Boisti13/esp32-sendspin-speaker/README.md

# ESP32 Sendspin Speaker






A network speaker for Home Assistant and Music Assistant on an ESP32-A1S
audio board. It plays [Sendspin](https://www.sendspin-audio.com/) streams
(Music Assistant's synchronised multi-room audio), shows what's playing on a
small colour screen and has hardware buttons for play/pause, volume and
tracks. Built with ESPHome.

> Since v0.2.0 it uses the Sendspin components built into ESPHome 2026.10;
> no pull requests or external components any more.

## Highlights

- **Sendspin player**: shows up in Music Assistant as a player and plays in
  sync with other Sendspin speakers.
- **ES8388 codec** on the A1S board, stereo, 48 kHz / 32-bit I²S; output
  set to both outputs (speaker and headphone) at boot, on the device itself.
- **Amplifier switched with playback**: on 150 ms after playback starts
  (no pop while the codec settles), off 300 ms after it stops or pauses (no
  click on the last audio).
- **1.47" screen** (320 × 172 landscape, ST7789V): play/pause icon, volume,
  IP address, title and artist. Long names end in "...", accented letters
  (ä, ö, ü, ß, é) are in the font. Redrawn only when something changes.
- **Rides out Wi-Fi gaps**: 2.5 MB of audio buffered ahead in PSRAM
  (Sendspin's default is 1 MB, about 5 s).
- **Diagnostics in Home Assistant**: Wi-Fi signal, uptime, free PSRAM and
  heap, and the reason for the last restart. A signal worse than about −70 dBm means dropouts: move the speaker
  or the access point, or use a board with an external antenna.
- **Five buttons that work without Home Assistant**: play/pause, previous,
  next, volume down/up go straight to the player and on to Music Assistant
  through Sendspin. Headphone jack detection.
- **Play picks up where you left off**: with nothing playing, even right
  after power-on, button 1 asks Music Assistant to play, and it resumes
  the speaker's queue with the last track.
- **Chime when it's online**: a short three-note chime when Wi-Fi first
  connects after power-on (not on later reconnects, and not over music).
  Built into the firmware. *Boot Sound* in Home Assistant turns it off;
  the setting survives restarts.

## Hardware

| Part | |
|---|---|
| Board | ESP32-A1S audio kit (ESP32-WROVER with PSRAM, ES8388 codec) |
| Codec | ES8388, I²C SDA 33 / SCL 32; I²S LRCLK 25, BCLK 27, DOUT 26, MCLK 0 |
| Amplifier enable | GPIO21 |
| Screen | Waveshare 1.47" 172 × 320, ST7789V; SPI CLK 14, MOSI 13, CS 15, DC 22, RST 12 |
| Headphone jack detect | GPIO39 |

### Buttons

| Button | Pin | Does | Entity in Home Assistant |
|---|---|---|---|
| 1 | GPIO36 | pause; when not playing, play (resumes Music Assistant's queue) | *Button 1 Play/Pause* |
| 2 | — | its pin (GPIO13) is the screen's MOSI | — |
| 3 | GPIO19 | previous track | *Button 3 Previous Track* |
| 4 | GPIO23 | next track | *Button 4 Next Track* |
| 5 | GPIO18 | volume down | *Button 5 Volume Down* |
| 6 | GPIO5 | volume up | *Button 6 Volume Up* |

The numbers are the ones printed on the board (KEY1–KEY6).

GPIO12 (screen reset) is a strapping pin: if it is high at power-on the
ESP32 picks 1.8 V flash and doesn't boot. Worth moving if boot is flaky.

### Custom PCB (in design)

A battery-powered board set of its own is being designed in KiCad in
[`hardware/`](hardware/README.md): a main board with the same ESP32-A1S
module, two 3 W amplifiers, a 1S LiPo charger and one USB-C port for
charging and flashing; a front panel with the screen (SPI like this one,
or an I²C OLED) and the buttons; a small USB-C board. Panel, USB-C,
battery, speakers, status LED, on/off switch and charge LEDs connect by
JST cable. It keeps the pins above, screen included, so it will get its
own `speaker-diy.yaml` with few changes. Not built yet.

## Install

| Step | |
|---|---|
| 1 | Copy `secrets.example.yaml` to `secrets.yaml` and fill in Wi-Fi, a new API key (`openssl rand -base64 32`) and an OTA password. In Home Assistant's ESPHome app the shared `secrets.yaml` gets `speaker_1_key` and `speaker_1_ota_password`. |
| 2 | Put `speaker.yaml`, `fonts/` and `sounds/` into the ESPHome folder. |
| 3 | Flash once over USB: `esphome run speaker.yaml`. After that, over Wi-Fi. |
| 4 | Add the device in Home Assistant with the API key. It needs no Home Assistant actions. |
| 5 | In Music Assistant, enable the Sendspin provider; the speaker appears as a player. |

## Example: playing an album

Start an album in Music Assistant on *Sendspin Media Player*. The board
switches to *playing*, waits 150 ms, turns the amplifier on and two seconds
later draws the screen once: pause icon, `VOL 65%`, the title in large type
and the artist below (*Die Ärzte* shows with its umlaut; a long title ends
in "..."). Press button 6 and the volume goes up a step; the screen redraws
with the new value. Press button 4 and Music Assistant skips to the next track.
Press button 1 to pause: the icon changes to play and the amplifier turns off
300 ms later.

## Layout

```
speaker.yaml           the whole device: board, codec, Sendspin, screen, buttons
requirements.txt       the ESPHome version it is tested with
fonts/                 Ubuntu Medium and Material Design Icons for the screen
sounds/boot.wav        the boot chime (1.5 s, 22 kHz mono)
scripts/make-boot-sound.py  makes sounds/boot.wav (synthesised, MIT like the rest)
secrets.example.yaml   the secrets the config expects
hardware/              KiCad 10 projects for the custom PCBs: main, front panel, USB-C (CERN-OHL-P-2.0)
```

## Development

- Check a change: `esphome config speaker.yaml`, then
  `esphome compile speaker.yaml`.
- ESPHome **2026.10.0** (`requirements.txt`), the version of Home
  Assistant's ESPHome app. Sendspin, `speaker_source` and `media_source`
  are built in since then; older versions don't have them.
- The screen has `update_interval: never`: every change that shows on it
  calls `component.update: tft_display`.
- Another boot sound: replace `sounds/boot.wav` (WAV, MP3, FLAC or Opus,
  short, ideally with ~300 ms of silence in front so the amplifier is on
  when it starts) or change and run `scripts/make-boot-sound.py`.

## License

MIT, see [LICENSE](LICENSE). The hardware in `hardware/` is under
CERN-OHL-P-2.0, see [hardware/LICENSE](hardware/LICENSE). Fonts: see
[THIRD_PARTY_NOTICES.md](THIRD_PARTY_NOTICES.md).
