Boisti13/esp32-sendspin-speaker/hardware/docs/main-bottom.png

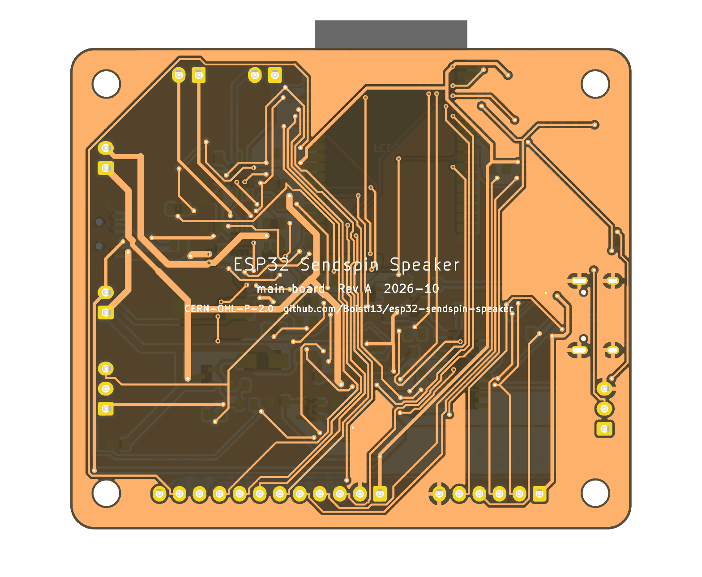
hardware/docs/main-bottom.png
