Boisti13/esp32-sendspin-speaker/CHANGELOG.md

# Changelog

## Unreleased

### Under the hood

- `hardware/`: empty KiCad 10 project for a custom battery-powered PCB
  (Rev A), with project-local libraries, the parts list and pin plan in
  `hardware/README.md`, and CERN-OHL-P-2.0 for the hardware.
- `hardware/` split into three boards — main (`main/`), front panel with
  OLED and buttons (`ui/`), USB-C (`usb/`) — with a JST connector plan for
  the panel, USB-C (or USB-C on the main board), LiPo, speakers and
  status LED. SMD passives and LEDs in 0805 wherever possible.
- Main board block diagram: hierarchical sheets USB, Power, MCU, Audio
  and Connectors with their signals, each sheet listing what goes in it.
- Footprints for every part (`hardware/README.md`): KiCad's libraries,
  plus ESP32-A1S, NS4150B, FS8205A, MSK12C02 and PJ-320D imported from LCSC
  into `hardware/lib/lcsc` (A1S with an antenna keepout).
- Pin plan reworked to the A1S's real pads (the codec's I²C/I²S are inside
  the module): display on the ST7789's pins 14/13/15/22, SPI or I²C;
  status LED on 12, CHRG/STDBY on 4/2 through diodes. On/off switch and
  charge LEDs can go off-board (J_SW, J_CHG).
- MCU sheet drawn: ESP32-A1S with all pads wired (unused mic/line-in pads
  marked), 22 µF + 100 nF, EN 10k/1 µF with Reset, Boot, pull-ups on
  GPIO36/39 and display CS, optional I²C pull-ups (not fitted), status LED
  on GPIO12 with its strap pull-down. The A1S symbol got real pin types.
  Draft generator in `hardware/scripts/`.
- Power sheet drawn: TP4056 (2.4k, ~500 mA) with on-board or J_CHG charge
  LEDs and BAT54W read-back to GPIO4/2, J_BAT + DW01A/FS8205A, load
  sharing (SS34, AO3401A), MSK12C02 / J_SW / solder-jumper bypass,
  AP2112K-3.3, battery divider on the cell (2 × 470k: on VBAT_SW it would
  read USB's 4.6 V while charging).
- Power sheet tidied: part texts placed where each symbol expects them,
  crowded labels and rail symbols moved apart (netlist unchanged).
- USB sheet: USB-C (or J_USB) with CC resistors and USBLC6-2SC6, CH340C on
  its own XC6206 3.3 V, TX/RX 470 Ω, UMH3N auto-reset. CH340C symbol copy
  with V3 as power input (tied to VCC).
- Audio sheet: 2 × NS4150B with 100n/100k inputs, bypass, supply caps,
  470 µF bulk, AMP_EN pull-down, speaker connectors, PJ-320D on 47 µF.
- Connectors sheet: J_UI (XH 12) and J_LED (through 330 Ω).
- Front panel and USB-C board schematics. ERC clean on all three projects.
- KiCad 10's local history folder (`.history/`) is ignored.
- Footprints and nets in all three boards (Update PCB from Schematic), JLC
  2-layer design rules and net classes (Power 1.0 mm, Speaker 0.6 mm).
- First placement: main board 90 × 58 mm, front panel 75 × 45 mm, USB-C
  board 32 × 20 mm, mounting holes, edge connectors, GND pours; renders in
  `hardware/docs/`. TP4056 footprint without 0.2 mm thermal vias; switch
  shell to GND.
- USB-C board and front panel are bare (connectors and buttons only), so any
  USB-C breakout or panel wiring can replace them: J_USB is now XH 6 with
  CC1/CC2 (CC resistors and ESD on the main board); J_UI's LED pin comes
  through R501; panel RC reset, decoupling and LED removed (ST7789 RST tied
  high). Boards updated and re-placed.
- J_BAT is a JST XH 2 like every other connector (was PH 2.0).
- Mounting holes 4.5 mm in from the edges so M3 screw heads stay on the
  board (M2: 3 mm); rounded board corners (r = 3 mm, USB-C board 2 mm).
- Main board placement refined: amps and speaker connectors next to the
  module's speaker outputs, every passive at the pin it serves (`pcbplace.py`
  finds the nearest free spot), connection length −23 %. PJ-320D footprint
  got a courtyard and its 3D model moved onto its pads.
- Main board routed with Freerouting (net classes Power 0.8 mm, Supply 0.4 mm),
  labelled (pin names at every connector, function labels, board name on
  the back), 100 × 58 mm to leave room for the labels. LCSC numbers on all
  SMD parts; `jlc.py` writes JLC's Gerber ZIP, BOM and CPL.
- Headphone jack removed from the custom PCB (J403, C422, C423): the module's
  headphone outputs stay open, GPIO39 is spare (pull-up kept).
- Main board shrunk to 70 × 60 mm: Boot/Reset, USB-C and J_LED on the left
  edge, J_USB and J_UI at the bottom. Routing clean-up: dangling vias and
  sub-minimum tracks fixed automatically after Freerouting.

## v0.7.7 — 2026-11-08

### Fixed

- Back on our sendspin-cpp 0.9.3 fork with the sync-task busy yield
  (tag `v0.9.3-busy-yield.1`, as in v0.7.5). The v0.7.6 test with plain
  upstream 0.9.4 restarted on 2026-11-08 (task watchdog, core 1): right
  after a reconnect, the sync task starved the main loop while priming
  silence at the stream start (`handle_initial_sync` →
  `send_pending_silence`). The busy yield covers that loop too. Reported on
  [#223](https://github.com/Sendspin/sendspin-cpp/issues/223).

## v0.7.6 — 2026-11-06

### Changed

- **Test build**: sendspin-cpp is now plain upstream
  [v0.9.4](https://github.com/Sendspin/sendspin-cpp/releases/tag/v0.9.4)
  instead of our 0.9.3 fork with the sync-task busy yield. The maintainer
  asked on [#223](https://github.com/Sendspin/sendspin-cpp/issues/223)
  whether 0.9.4's hard-sync fix
  ([#198](https://github.com/Sendspin/sendspin-cpp/pull/198): after the
  speaker runs dry, the next sync is measured from now, not from the end
  of the last audio) already ends the task-watchdog restarts after Wi-Fi
  stalls. If the restarts come back, v0.7.5's fork goes back in.

## v0.7.5 — 2026-11-03

### Fixed

- The speaker still restarted (task watchdog) after long Wi-Fi stalls:
  once the audio came back, Sendspin's sync task worked off the backlog
  without pausing and, together with the decryption of the refill, kept
  the main loop from running for over 5 s. The firmware now builds
  against a fork of sendspin-cpp 0.9.3 with a fix
  ([Boisti13/sendspin-cpp](https://github.com/Boisti13/sendspin-cpp),
  tag `v0.9.3-busy-yield.1`): the sync task sleeps 2 ms after 50 ms
  without waiting. Reported as
  [Sendspin/sendspin-cpp#223](https://github.com/Sendspin/sendspin-cpp/issues/223);
  the override goes once ESPHome ships a sendspin-cpp with the fix.

## v0.7.4 — 2026-11-02

### Added

- *Reset Reason* diagnostic sensor: why the chip last restarted
  (brownout, watchdog, power-on …). Since v0.7.3 the speaker still
  restarted once without a crash record and froze twice until it was
  power-cycled, which points at the power supply rather than the
  firmware; this sensor tells the cases apart.

## v0.7.3 — 2026-11-01

### Fixed

- Buffer back to 2.5 MB: v0.7.2's 1 MB made dropouts worse. The speaker
  sometimes takes no data for 4–50 s (with or without big refills), and
  1 MB (about 5 s) ran dry on every stall longer than that. v0.7.1's fixes
  (stacks in internal RAM, 240 MHz) stay.

## v0.7.2 — 2026-11-01

### Fixed

- The Sendspin buffer is back to its default 1 MB (was 2.5 MB). On
  v0.7.1, decrypting a full 2.5 MB refill after a reconnect still held
  up the main loop for 4.1–4.3 s, close to the 5 s watchdog, and Music
  Assistant's connection dropped and came back during refills. A refill
  is now 2.5 times shorter. Wi-Fi gaps of about 6–8 s are still bridged.

## v0.7.1 — 2026-11-01

### Fixed

- The speaker restarted every half hour or so while playing (task
  watchdog, crash in Sendspin's decryption of incoming audio). Refilling
  the 2.5 MB buffer — at every track start and after a Wi-Fi gap — kept
  Sendspin's task busy on the main loop's core long enough to starve it.
  Sendspin's task stacks now live in internal RAM instead of PSRAM, and
  the CPU runs at 240 MHz instead of 160 MHz, so the decryption keeps up.

## v0.7.0 — 2026-10-29

### Changed

- The chime plays when Wi-Fi first connects after boot instead of at
  power-on, so it also says "online". Not on later reconnects, and not
  while something plays.
- Button 1: when nothing is playing it sends Sendspin's *play* to Music
  Assistant, which resumes the speaker's queue with the last track. Before,
  it did nothing after boot (the player had nothing loaded) and replayed
  the chime in v0.6.0.

## v0.6.1 — 2026-10-29

### Fixed

- Play/pause with no music played since boot replayed the boot chime (it
  stayed in the player's playlist). The player is stopped once the chime
  has ended, which empties the playlist; play/pause then does nothing until
  music has played, as before v0.6.0.

## v0.6.0 — 2026-10-29

### Added

- Boot chime: three rising notes at power-on, played through the player
  from a file built into the firmware (`sounds/boot.wav`, made by
  `scripts/make-boot-sound.py`). Switch *Boot Sound* (config, on by
  default, remembered) turns it off.
- `sounds/` must now be next to `speaker.yaml` in the ESPHome folder.

## v0.5.0 — 2026-10-27

### Added

- Diagnostic sensors: *Wi-Fi Signal*, *Uptime*, *Free PSRAM*, *Free Heap*.

### Fixed

- Music stopped after a Wi-Fi stall of ~25 s: the Sendspin buffer (1 MB by
  default) ran dry. It is 2.5 MB now. Much longer gaps still stop the
  music; the signal sensor shows whether the Wi-Fi is the cause.

## v0.4.0 — 2026-10-27

### Changed

- New button layout: 1 play/pause, 3 previous track, 4 next track,
  5 volume down, 6 volume up. The entities are renamed to match
  (*Button 1 Play/Pause* …), so their entity IDs change again.

## v0.3.0 — 2026-10-27

### Changed

- The buttons are named after what they do: *Button 1 Previous Track*,
  *Button 3 Next Track*, *Button 4 Volume Down*, *Button 5 Volume Up*,
  *Button 6 Play/Pause* (were *Key 1* … *Key 6*). **New entity IDs**
  (`binary_sensor.speaker_1_button_1_previous_track` …): the old
  `binary_sensor.speaker_1_key_*` entities stay behind unavailable and can
  be removed.

### Under the hood

- `CLAUDE.md`: Home Assistant now has the v0.2.0 copy and the OTA secret.

## v0.2.0 — 2026-10-27

Needs ESPHome 2026.10 or later.

### Changed

- Uses the Sendspin, `speaker_source` and `media_source` components built
  into ESPHome 2026.10 instead of pull-request copies (v0.1.0 no longer
  validated). The player's speaker and source moved into `media_pipeline:`;
  `kalman_process_error` is gone (the built-in Sendspin has no such option).
- Previous, next and play/pause keys go straight to the player, which
  passes them on to Music Assistant through Sendspin: they work without
  Home Assistant, and the device no longer needs Home Assistant actions.
- Log level INFO instead of DEBUG.

### Fixed

- The DAC output wasn't set to *BOTH* at boot: the Home Assistant call ran
  before the API was connected. It is set on the device now.
- Previous/next called `media_player.speaker_1`, an entity that doesn't
  exist.
- Every volume change while playing restarted the start-up sequence
  (amplifier on, two seconds without redraws): `on_state` also fires on
  volume changes. Only real starts and stops count now.
- The amplifier switched off immediately when playback stopped or paused,
  clipping the last audio with a click; it now waits 300 ms.
- The volume on the screen was right-aligned to x = 164 (the portrait
  width), mid-screen in landscape. It uses the screen width now.
- Long titles and artists are shortened with "..." instead of being cut
  off at the edge; ä, ö, ü, ß and other accented letters are in the font
  (`GF_Latin_Core`).

### Under the hood

- Volume redraws come from `on_volume` instead of a template sensor
  polling every 2 s.
- Unused globals and the Wi-Fi SSID sensor removed; key pins written
  `GPIO23` / `GPIO18`; Key 3 gets the internal pull-up.
- `requirements.txt` with the tested ESPHome version.

## v0.1.0 — 2026-10-27

First version in git: the config as it ran from Home Assistant's ESPHome
folder (`speaker-test.yaml`), built against ESPHome pull requests from late
2025.

### Added

- Sendspin player on an ESP32-A1S (ES8388 codec), amplifier switched with
  playback.
- 1.47" ST7789V screen with play state, volume, IP, title and artist.
- Buttons for previous/next track, volume and play/pause; headphone jack
  sensor.

### Under the hood

- OTA password moved to `secrets.yaml` (`speaker_1_ota_password`); unused
  `ha_base_url` / `ha_token` substitutions removed.
- `project:` name and version added.
