Boisti13/esp32-sendspin-speaker/hardware/main/sendspin-speaker-main.kicad_pcb

## KiCad design hardware/main/sendspin-speaker-main.kicad_pcb (2026-10-30)

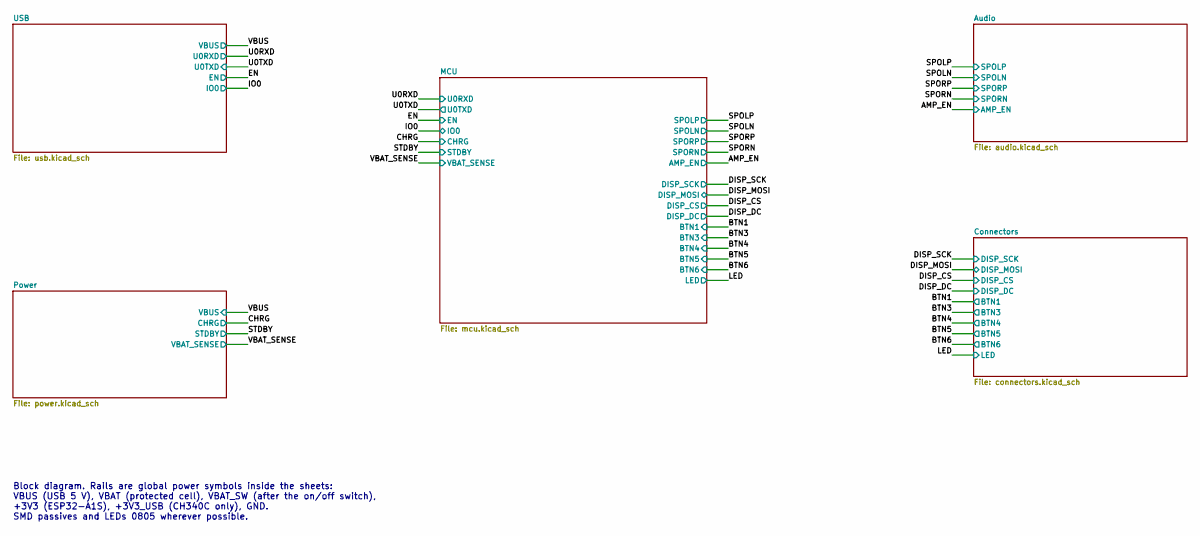
[picture p5: schematic sendspin-speaker-main.kicad_sch, ESP32 Sendspin Speaker — main board]

Notes on the sheet:
Block diagram. Rails are global power symbols inside the sheets: VBUS (USB 5 V), VBAT (protected cell), VBAT_SW (after the on/off switch), +3V3 (ESP32-A1S), +3V3_USB (CH340C only), GND. SMD passives and LEDs 0805 wherever possible.

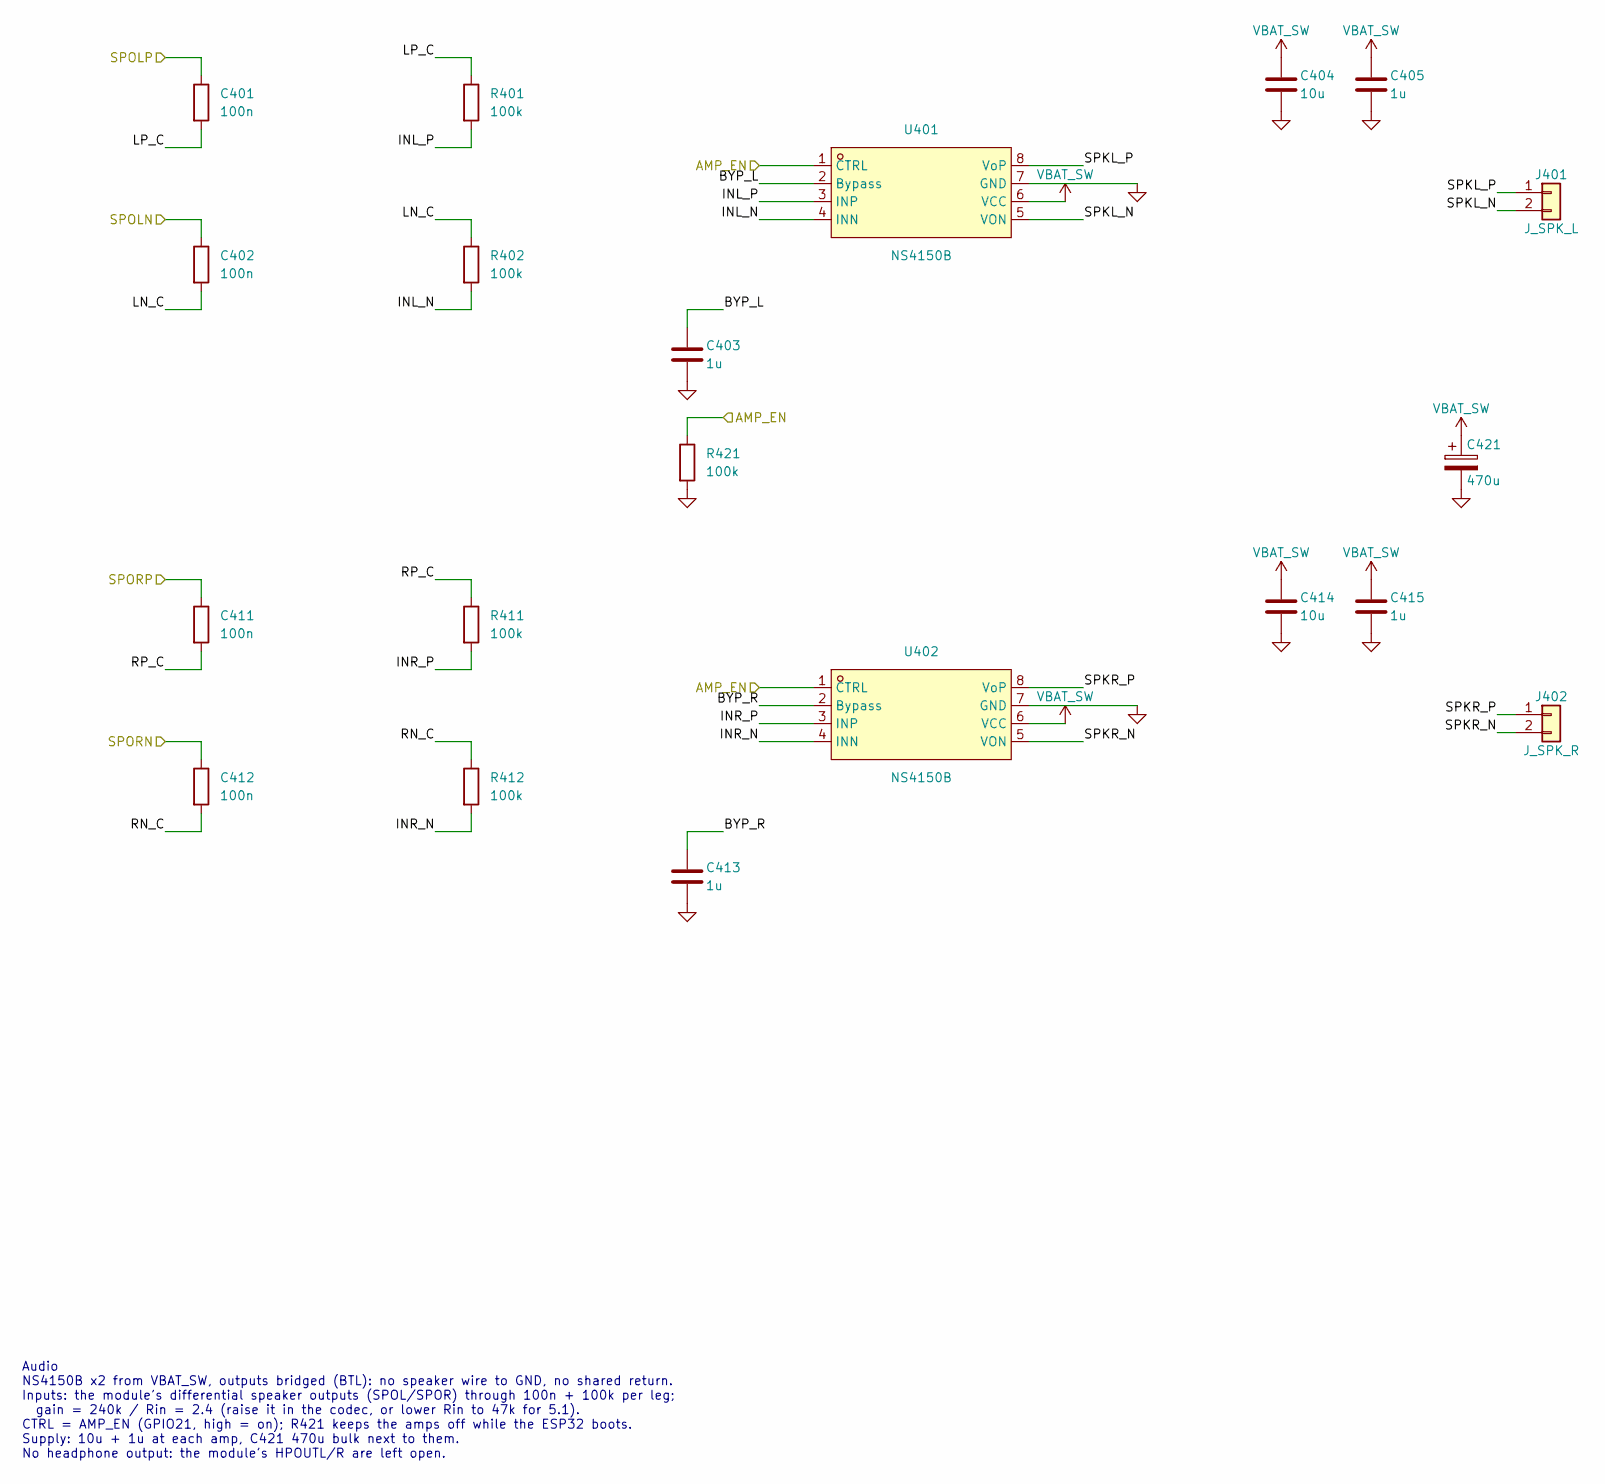
[picture p6: schematic audio.kicad_sch, ESP32 Sendspin Speaker — main board — Audio]

Parts:
C401, C402, C411, C412: 100n; C_0805_2012Metric; LCSC C49678
C403, C405, C413, C415: 1u; C_0805_2012Metric; LCSC C28323
C404, C414: 10u; C_0805_2012Metric; LCSC C15850
C421: 470u; CP_Elec_8x10; LCSC C249545
J401: J_SPK_L; JST_XH_B2B-XH-A_1x02_P2.50mm_Vertical
J402: J_SPK_R; JST_XH_B2B-XH-A_1x02_P2.50mm_Vertical
R401, R402, R411, R412, R421: 100k; R_0805_2012Metric; LCSC C149504
U401, U402: NS4150B; MSOP-8_L3.0-W3.0-P0.65-LS5.0-BL; LCSC C189961

Connections:
/AMP_EN: R421.1, U401.1 (CTRL), U402.1 (CTRL); also elsewhere on the board
/Audio/BYP_L: C403.1, U401.2 (Bypass)
/Audio/BYP_R: C413.1, U402.2 (Bypass)
/Audio/INL_N: R402.2, U401.4 (INN)
/Audio/INL_P: R401.2, U401.3 (INP)
/Audio/INR_N: R412.2, U402.4 (INN)
/Audio/INR_P: R411.2, U402.3 (INP)
/Audio/LN_C: C402.2, R402.1
/Audio/LP_C: C401.2, R401.1
/Audio/RN_C: C412.2, R412.1
/Audio/RP_C: C411.2, R411.1
/Audio/SPKL_N: J401.2, U401.5 (VON)
/Audio/SPKL_P: J401.1, U401.8 (VoP)
/Audio/SPKR_N: J402.2, U402.5 (VON)
/Audio/SPKR_P: J402.1, U402.8 (VoP)
/SPOLN: C402.1; also elsewhere on the board
/SPOLP: C401.1; also elsewhere on the board
/SPORN: C412.1; also elsewhere on the board
/SPORP: C411.1; also elsewhere on the board
GND: C403.2, C404.2, C405.2, C413.2, C414.2, C415.2, C421.2, R421.2, U401.7 (GND), U402.7 (GND); also elsewhere on the board
VBAT_SW: C404.1, C405.1, C414.1, C415.1, C421.1, U401.6 (VCC), U402.6 (VCC); also elsewhere on the board

Notes on the sheet:
Audio NS4150B x2 from VBAT_SW, outputs bridged (BTL): no speaker wire to GND, no shared return. Inputs: the module's differential speaker outputs (SPOL/SPOR) through 100n + 100k per leg; gain = 240k / Rin = 2.4 (raise it in the codec, or lower Rin to 47k for 5.1). CTRL = AMP_EN (GPIO21, high = on);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

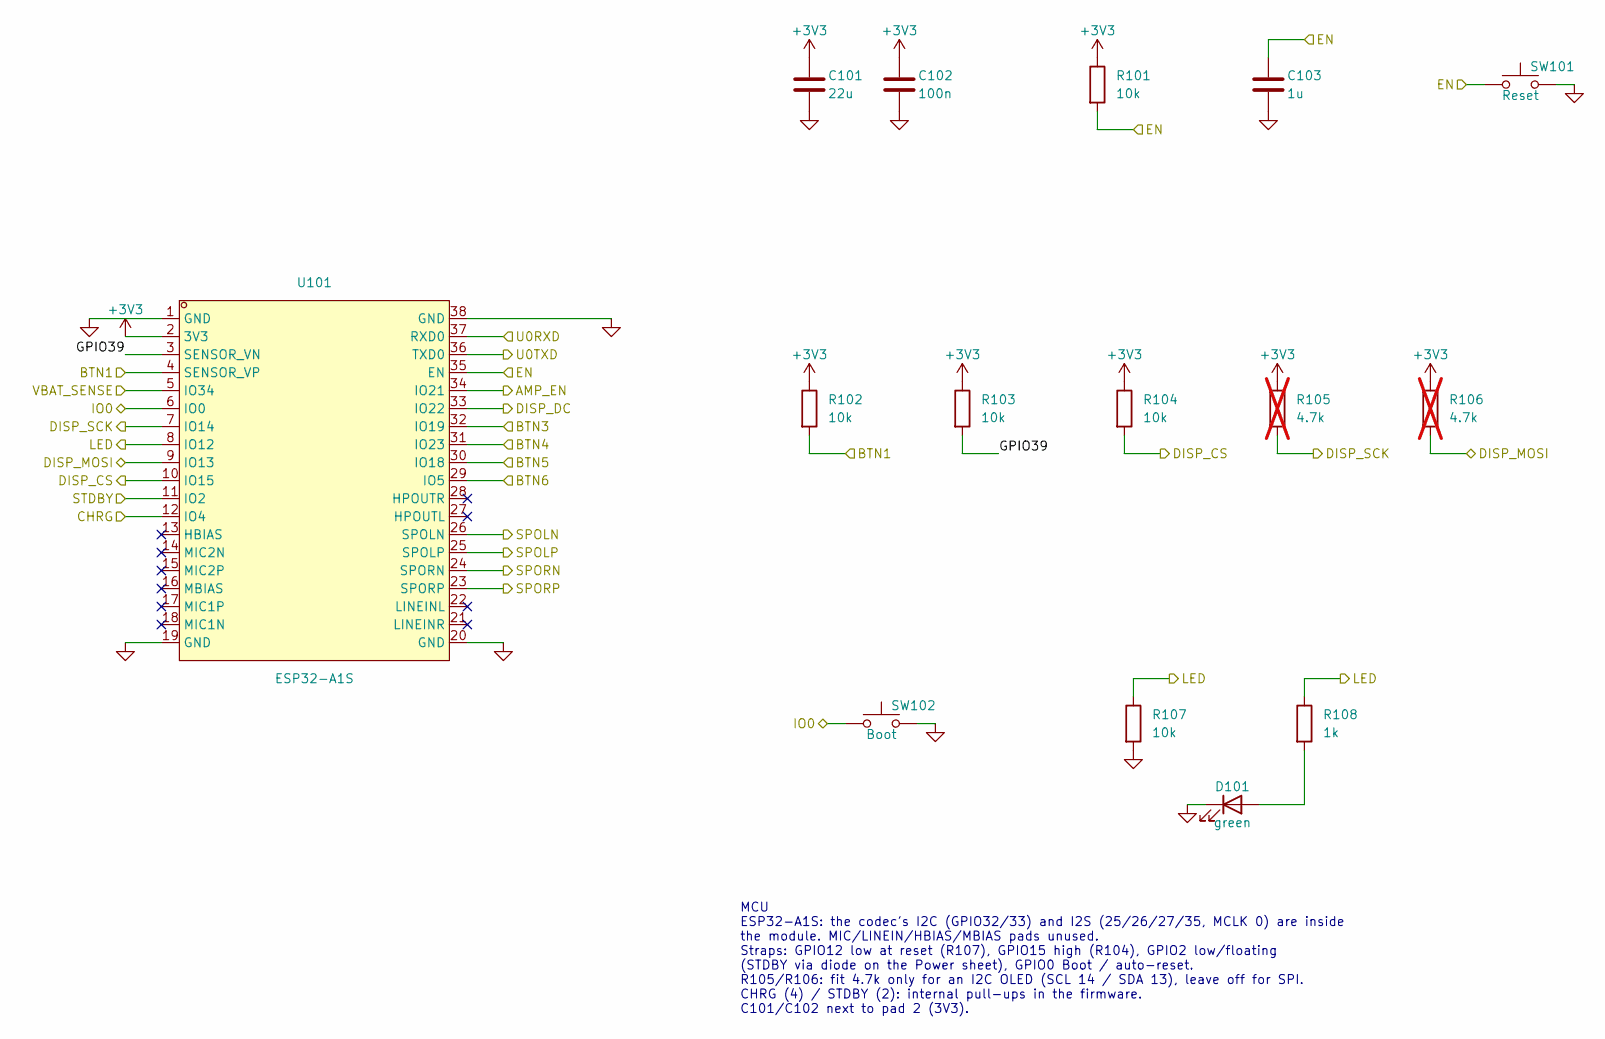
[picture p7: schematic mcu.kicad_sch, ESP32 Sendspin Speaker — main board — MCU]

Parts:
C101: 22u; C_0805_2012Metric; LCSC C45783
C102: 100n; C_0805_2012Metric; LCSC C49678
C103: 1u; C_0805_2012Metric; LCSC C28323
D101: green; LED_0805_2012Metric; LCSC C2297
R101, R102, R103, R104, R107: 10k; R_0805_2012Metric; LCSC C17414
R105, R106: 4.7k; R_0805_2012Metric; LCSC C17673; not fitted
R108: 1k; R_0805_2012Metric; LCSC C17513
SW101: Reset; SW_Push_1P1T_XKB_TS-1187A; LCSC C318884
SW102: Boot; SW_Push_1P1T_XKB_TS-1187A; LCSC C318884
U101: ESP32-A1S; WIRELM-SMD_ESP32-A1S; LCSC C277945

Connections:
+3V3: C101.1, C102.1, R101.1, R102.1, R103.1, R104.1, R105.1, R106.1, U101.2 (3V3); also elsewhere on the board
/AMP_EN: U101.34 (IO21); also elsewhere on the board
/BTN1: R102.2, U101.4 (SENSOR_VP); also elsewhere on the board
/BTN3: U101.32 (IO19); also elsewhere on the board
/BTN4: U101.31 (IO23); also elsewhere on the board
/BTN5: U101.30 (IO18); also elsewhere on the board
/BTN6: U101.29 (IO5); also elsewhere on the board
/CHRG: U101.12 (IO4); also elsewhere on the board
/DISP_CS: R104.2, U101.10 (IO15); also elsewhere on the board
/DISP_DC: U101.33 (IO22); also elsewhere on the board
/DISP_MOSI: R106.2, U101.9 (IO13); also elsewhere on the board
/DISP_SCK: R105.2, U101.7 (IO14); also elsewhere on the board
/EN: C103.1, R101.2, SW101.1, U101.35 (EN); also elsewhere on the board
/IO0: SW102.1, U101.6 (IO0); also elsewhere on the board
/LED: R107.1, R108.1, U101.8 (IO12); also elsewhere on the board
/MCU/GPIO39: R103.2, U101.3 (SENSOR_VN)
/SPOLN: U101.26 (SPOLN); also elsewhere on the board
/SPOLP: U101.25 (SPOLP); also elsewhere on the board
/SPORN: U101.24 (SPORN); also elsewhere on the board
/SPORP: U101.23 (SPORP); also elsewhere on the board
/STDBY: U101.11 (IO2); also elsewhere on the board
/U0RXD: U101.37 (RXD0); also elsewhere on the board
/U0TXD: U101.36 (TXD0); also elsewhere on the board
/VBAT_SENSE: U101.5 (IO34); also elsewhere on the board
GND: C101.2, C102.2, C103.2, D101.1 (K), R107.2, SW101.2, SW102.2, U101.1 (GND), U101.19 (GND), U101.20 (GND), U101.38 (GND); also elsewhere on the board
unnamed: D101.2 (A), R108.2

Notes on the sheet:
MCU ESP32-A1S: the codec's I2C (GPIO32/33) and I2S (25/26/27/35, MCLK 0) are inside the module. MIC/LINEIN/HBIAS/MBIAS pads unused. Straps: GPIO12 low at reset (R107), GPIO15 high (R104), GPIO2 low/floating (STDBY via diode on the Power sheet), GPIO0 Boot / auto-reset. R105/R106: fit 4.7k only for 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

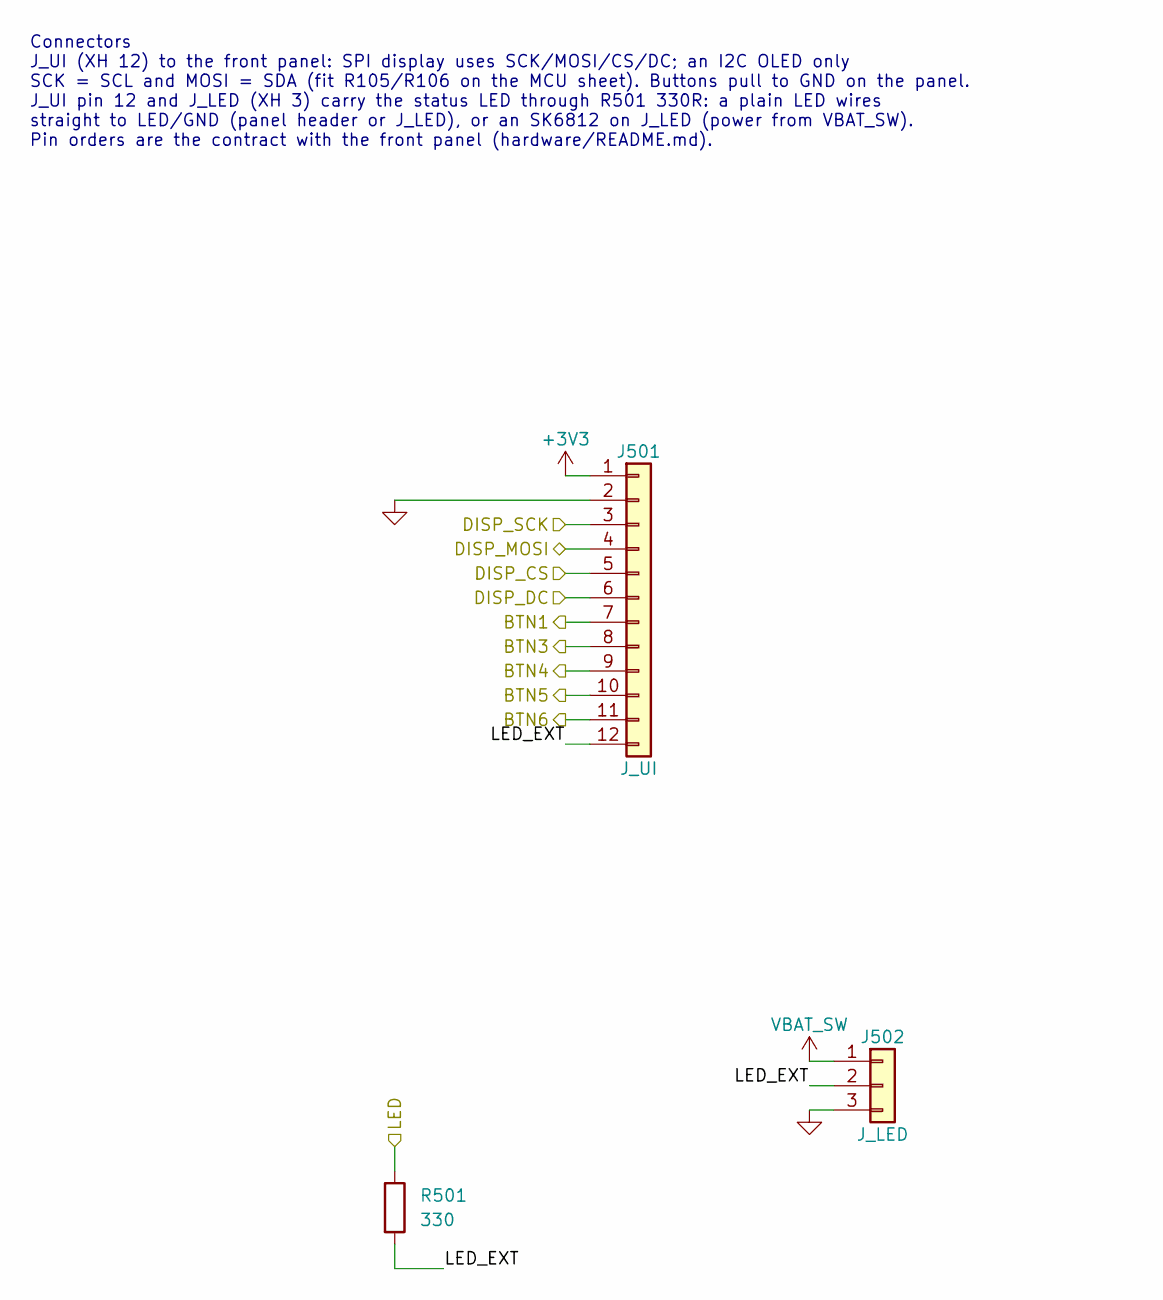
[picture p8: schematic connectors.kicad_sch, ESP32 Sendspin Speaker — main board — Connectors]

Parts:
J501: J_UI; JST_XH_B12B-XH-A_1x12_P2.50mm_Vertical
J502: J_LED; JST_XH_B3B-XH-A_1x03_P2.50mm_Vertical
R501: 330; R_0805_2012Metric; LCSC C17630

Connections:
+3V3: J501.1; also elsewhere on the board
/BTN1: J501.7; also elsewhere on the board
/BTN3: J501.8; also elsewhere on the board
/BTN4: J501.9; also elsewhere on the board
/BTN5: J501.10; also elsewhere on the board
/BTN6: J501.11; also elsewhere on the board
/Connectors/LED_EXT: J501.12, J502.2, R501.2
/DISP_CS: J501.5; also elsewhere on the board
/DISP_DC: J501.6; also elsewhere on the board
/DISP_MOSI: J501.4; also elsewhere on the board
/DISP_SCK: J501.3; also elsewhere on the board
/LED: R501.1; also elsewhere on the board
GND: J501.2, J502.3; also elsewhere on the board
VBAT_SW: J502.1; also elsewhere on the board

Notes on the sheet:
Connectors J_UI (XH 12) to the front panel: SPI display uses SCK/MOSI/CS/DC; an I2C OLED only SCK = SCL and MOSI = SDA (fit R105/R106 on the MCU sheet). Buttons pull to GND on the panel. J_UI pin 12 and J_LED (XH 3) carry the status LED through R501 330R: a plain LED wires straight to LED/GND (pane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

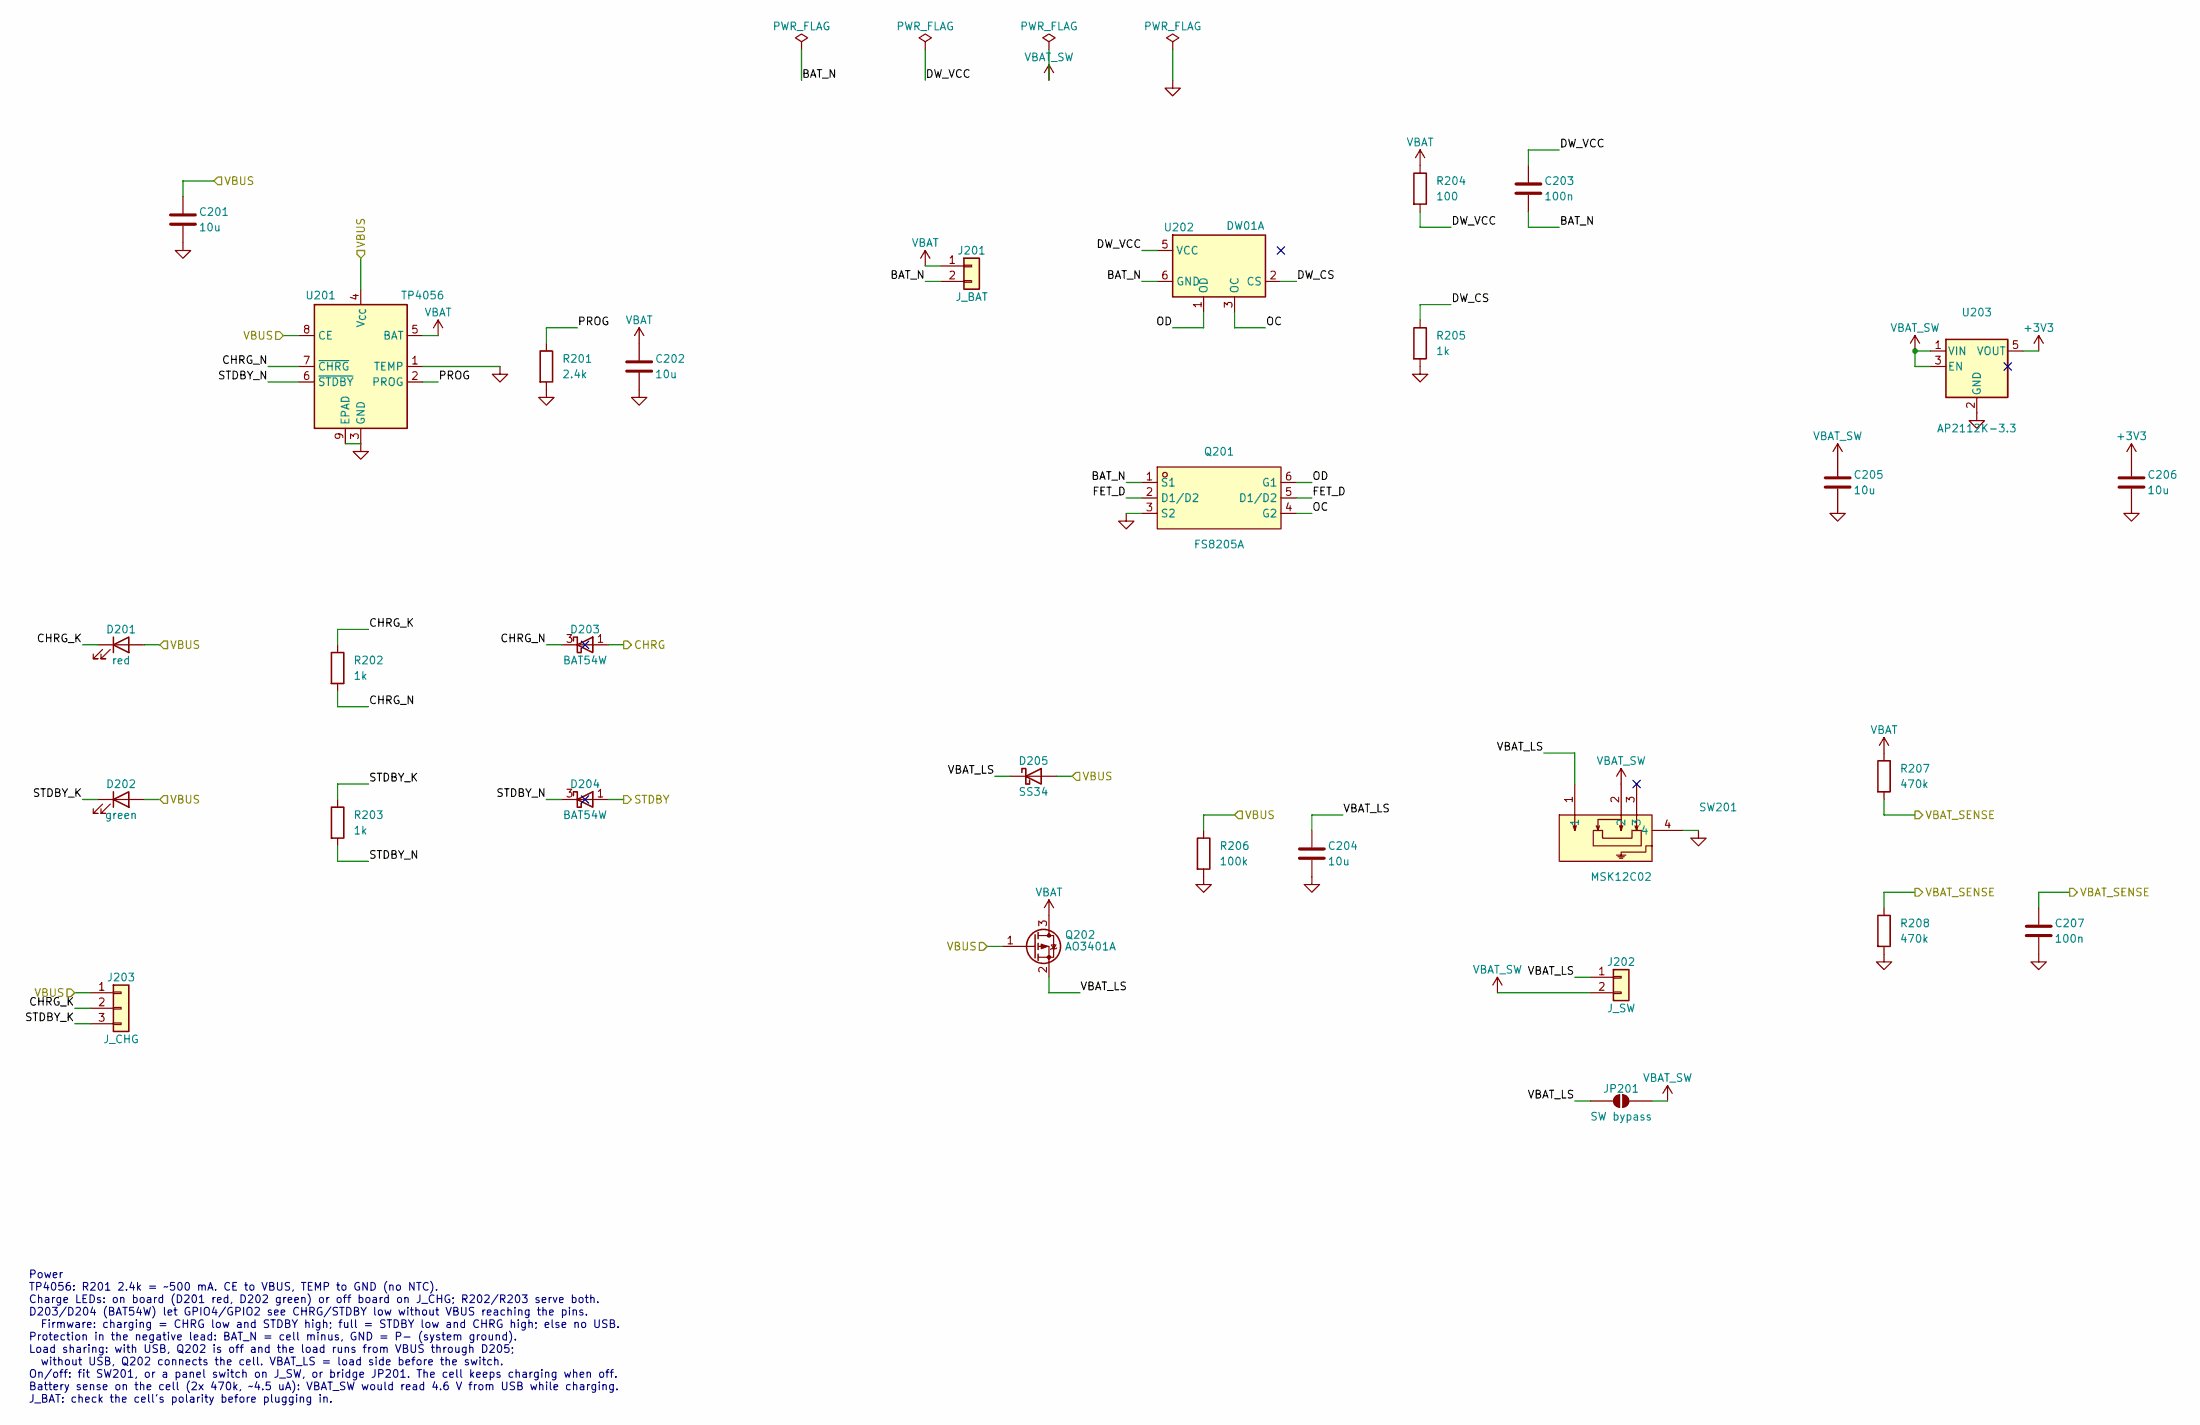
[picture p9: schematic power.kicad_sch, ESP32 Sendspin Speaker — main board — Power]

Parts:
C201, C202, C204, C205, C206: 10u; C_0805_2012Metric; LCSC C15850
C203, C207: 100n; C_0805_2012Metric; LCSC C49678
D201: red; LED_0805_2012Metric; LCSC C84256
D202: green; LED_0805_2012Metric; LCSC C2297
D203, D204: BAT54W; SOT-323_SC-70; LCSC C2992467
D205: SS34; D_SMA; LCSC C8678
J201: J_BAT; JST_XH_B2B-XH-A_1x02_P2.50mm_Vertical
J202: J_SW; JST_XH_B2B-XH-A_1x02_P2.50mm_Vertical
J203: J_CHG; JST_XH_B3B-XH-A_1x03_P2.50mm_Vertical
JP201: SW bypass; SolderJumper-2_P1.3mm_Open_RoundedPad1.0x1.5mm
Q201: FS8205A; SOT-23-6_L2.9-W1.6-P0.95-LS2.8-BR; LCSC C2830320
Q202: AO3401A; SOT-23; LCSC C15127
R201: 2.4k; R_0805_2012Metric; LCSC C17526
R202, R203, R205: 1k; R_0805_2012Metric; LCSC C17513
R204: 100; R_0805_2012Metric; LCSC C17408
R206: 100k; R_0805_2012Metric; LCSC C149504
R207, R208: 470k; R_0805_2012Metric; LCSC C17709
SW201: MSK12C02; SW-TH_MSK12C02; LCSC C431540
U201: TP4056; SOIC-8-1EP_3.9x4.9mm_P1.27mm_EP2.41x3.3mm; LCSC C16581
U202: DW01A; SOT-23-6; LCSC C351410
U203: AP2112K-3.3; SOT-23-5; LCSC C51118

Connections:
+3V3: C206.1, U203.5 (VOUT); also elsewhere on the board
/CHRG: D203.1 (A); also elsewhere on the board
/Power/BAT_N: C203.2, J201.2, Q201.1 (S1), U202.6 (GND)
/Power/CHRG_K: D201.1 (K), J203.2, R202.1
/Power/CHRG_N: D203.3 (K), R202.2, U201.7 (~CHRG)
/Power/DW_CS: R205.1, U202.2 (CS)
/Power/DW_VCC: C203.1, R204.2, U202.5 (VCC)
/Power/FET_D: Q201.2 (D1/D2), Q201.5 (D1/D2)
/Power/OC: Q201.4 (G2), U202.3 (OC)
/Power/OD: Q201.6 (G1), U202.1 (OD)
/Power/PROG: R201.1, U201.2 (PROG)
/Power/STDBY_K: D202.1 (K), J203.3, R203.1
/Power/STDBY_N: D204.3 (K), R203.2, U201.6 (~STDBY)
/Power/VBAT_LS: C204.1, D205.1 (K), J202.1, JP201.1 (A), Q202.2 (S), SW201.1
/STDBY: D204.1 (A); also elsewhere on the board
/VBAT_SENSE: C207.1, R207.2, R208.1; also elsewhere on the board
/VBUS: C201.1, D201.2 (A), D202.2 (A), D205.2 (A), J203.1, Q202.1 (G), R206.1, U201.4 (V_{CC}), U201.8 (CE); also elsewhere on the board
GND: C201.2, C202.2, C204.2, C205.2, C206.2, C207.2, Q201.3 (S2), R201.2, R205.2, R206.2, R208.2, SW201.4, U201.1 (TEMP), U201.3 (GND), U201.9 (EPAD), U203.2 (GND); also elsewhere on the board
VBAT: C202.1, J201.1, Q202.3 (D), R204.1, R207.1, U201.5 (BAT)
VBAT_SW: C205.1, J202.2, JP201.2 (B), SW201.2, U203.1 (VIN), U203.3 (EN); also elsewhere on the board

Notes on the sheet:
Power TP4056: R201 2.4k = ~500 mA. CE to VBUS, TEMP to GND (no NTC). Charge LEDs: on board (D201 red, D202 green) or off board on J_CHG; R202/R203 serve both. D203/D204 (BAT54W) let GPIO4/GPIO2 see CHRG/STDBY low without VBUS reaching the pins. Firmware: charging = CHRG low and STDBY high; full = S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

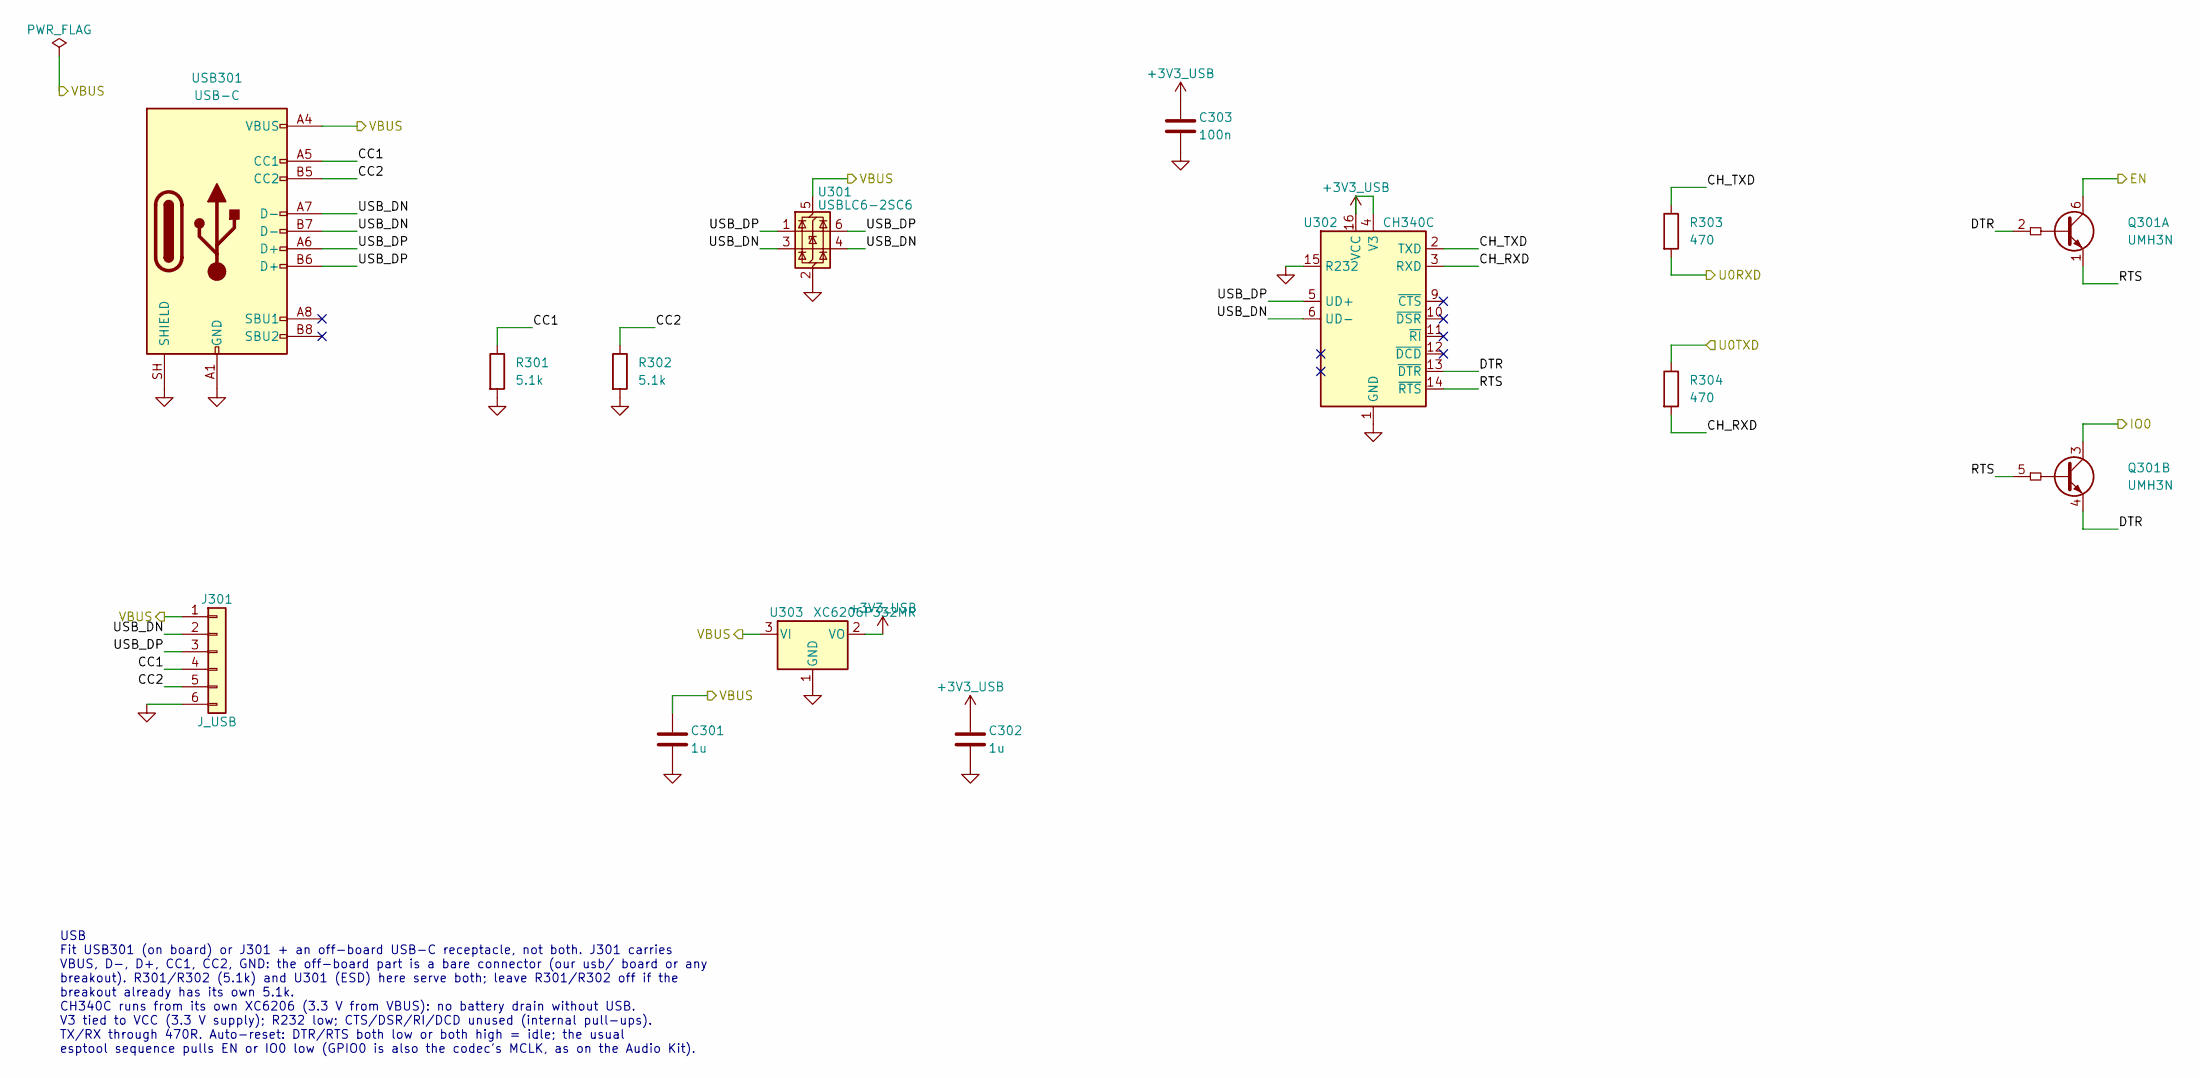
[picture p10: schematic usb.kicad_sch, ESP32 Sendspin Speaker — main board — USB]

Parts:
C301, C302: 1u; C_0805_2012Metric; LCSC C28323
C303: 100n; C_0805_2012Metric; LCSC C49678
J301: J_USB; JST_XH_B6B-XH-A_1x06_P2.50mm_Vertical
Q301: UMH3N; SOT-363_SC-70-6; LCSC C123008
R301, R302: 5.1k; R_0805_2012Metric; LCSC C27834
R303, R304: 470; R_0805_2012Metric; LCSC C17710
U301: USBLC6-2SC6; SOT-23-6; LCSC C7519
U302: CH340C; SOIC-16_3.9x9.9mm_P1.27mm; LCSC C84681
U303: XC6206P332MR; SOT-23-3; LCSC C5446
USB301: USB-C; USB_C_Receptacle_HRO_TYPE-C-31-M-12; LCSC C165948

Connections:
+3V3_USB: C302.1, C303.1, U302.4 (V3), U302.16 (VCC), U303.2 (VO)
/EN: Q301.6 (C1); also elsewhere on the board
/IO0: Q301.3 (C2); also elsewhere on the board
/U0RXD: R303.2; also elsewhere on the board
/U0TXD: R304.1; also elsewhere on the board
/USB/CC1: J301.4, R301.1, USB301.A5 (CC1)
/USB/CC2: J301.5, R302.1, USB301.B5 (CC2)
/USB/CH_RXD: R304.2, U302.3 (RXD)
/USB/CH_TXD: R303.1, U302.2 (TXD)
/USB/DTR: Q301.2 (B1), Q301.4 (E2), U302.13 (~DTR)
/USB/RTS: Q301.1 (E1), Q301.5 (B2), U302.14 (~RTS)
/USB/USB_DN: J301.2, U301.3 (I/O2), U301.4 (I/O2), U302.6 (UD-), USB301.A7 (D-), USB301.B7 (D-)
/USB/USB_DP: J301.3, U301.1 (I/O1), U301.6 (I/O1), U302.5 (UD+), USB301.A6 (D+), USB301.B6 (D+)
/VBUS: C301.1, J301.1, U301.5 (VBUS), U303.3 (VI), USB301.A4 (VBUS), USB301.A9 (VBUS), USB301.B4 (VBUS), USB301.B9 (VBUS); also elsewhere on the board
GND: C301.2, C302.2, C303.2, J301.6, R301.2, R302.2, U301.2 (GND), U302.1 (GND), U302.15 (R232), U303.1 (GND), USB301.A1 (GND), USB301.A12 (GND), USB301.B1 (GND), USB301.B12 (GND), USB301.SH (SHIELD); also elsewhere on the board

Notes on the sheet:
USB Fit USB301 (on board) or J301 + an off-board USB-C receptacle, not both. J301 carries VBUS, D-, D+, CC1, CC2, GND: the off-board part is a bare connector (our usb/ board or any breakout). R301/R302 (5.1k) and U301 (ESD) here serve both; leave R301/R302 off if the breakout already has its own 5.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

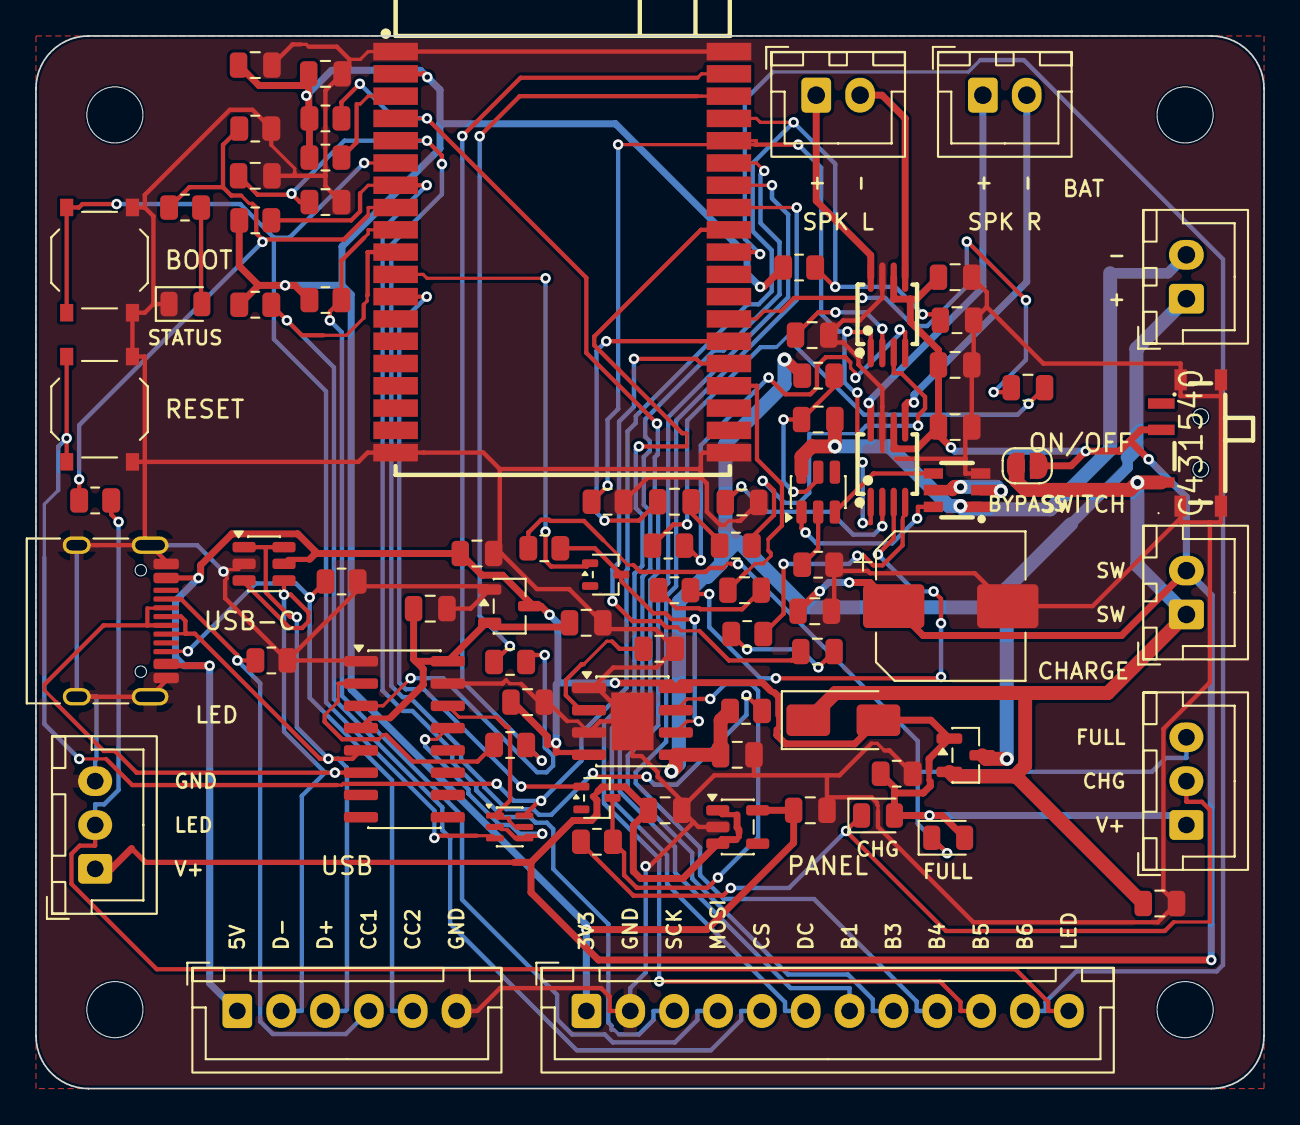
[picture p11: board sendspin-speaker-main.kicad_pcb from above]

Board: 2 copper layers, 70.0 x 60.0 mm, 85 parts (0 on the bottom side), 65 nets.

Other parts of the board:
H1, H2, H3, H4: MountingHole_3.2mm_M3
