Boisti13/esp32-sendspin-speaker/hardware/ui/sendspin-speaker-ui.kicad_pcb

## KiCad design hardware/ui/sendspin-speaker-ui.kicad_pcb (2026-10-30)

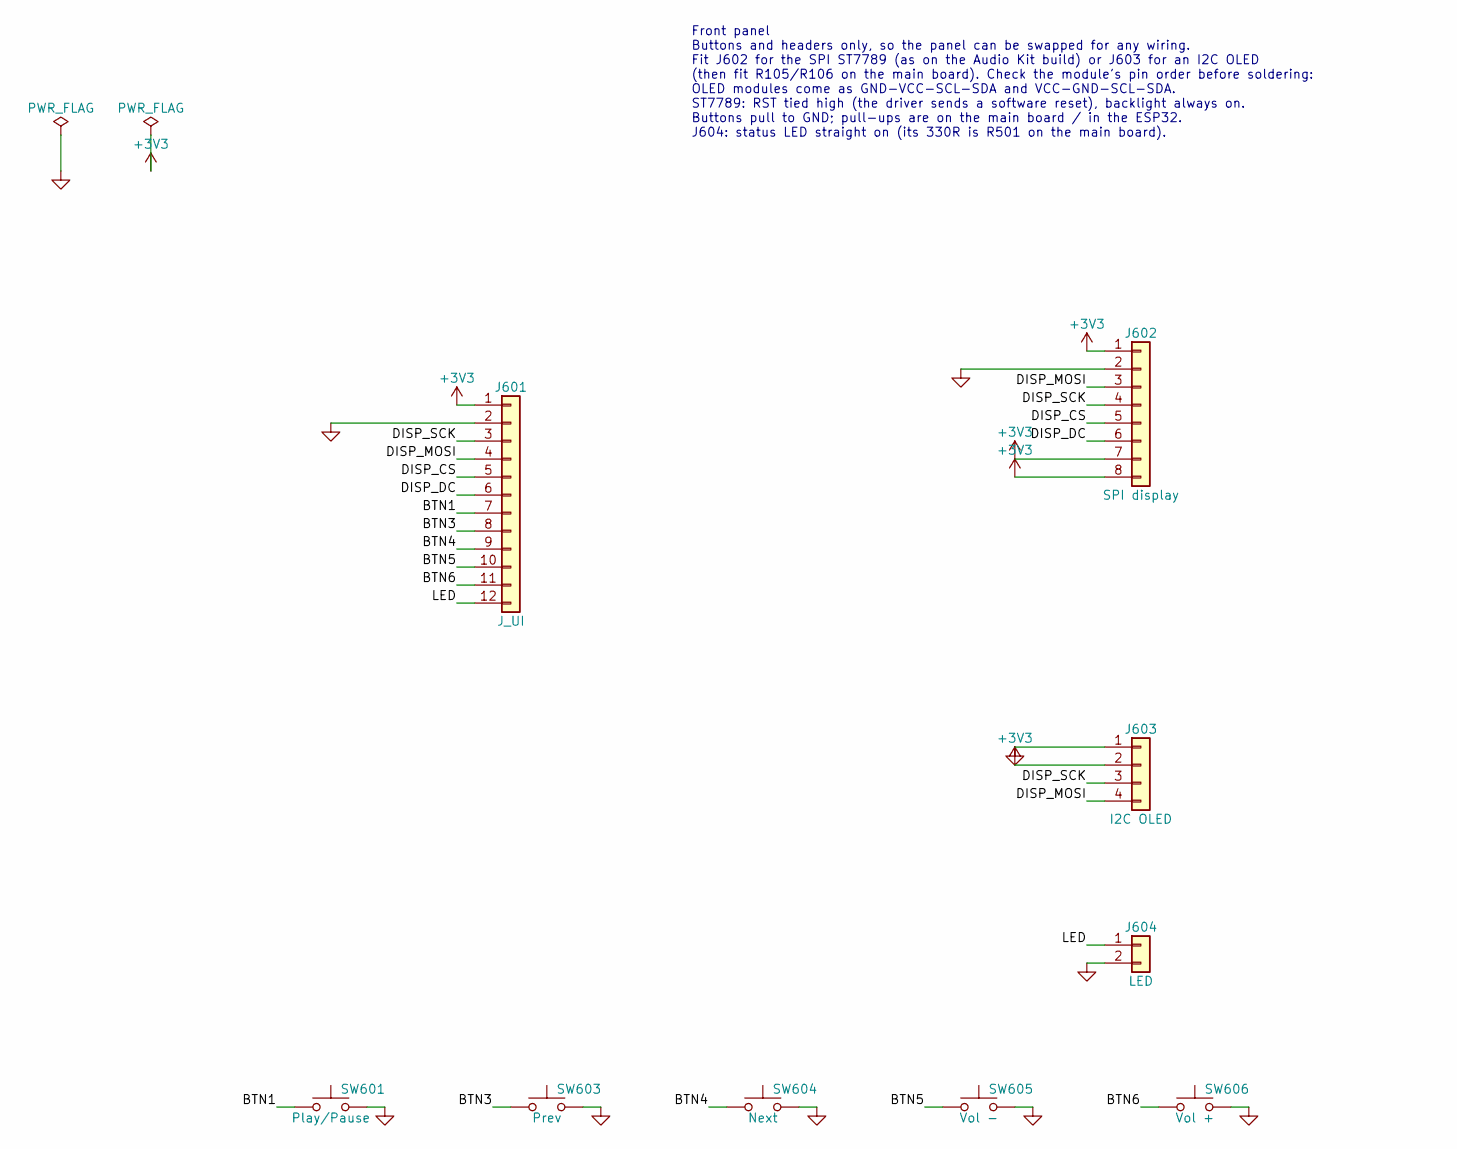
[picture p12: schematic sendspin-speaker-ui.kicad_sch, ESP32 Sendspin Speaker — front panel (display + buttons)]

Parts:
J601: J_UI; JST_XH_B12B-XH-A_1x12_P2.50mm_Vertical
J602: SPI display; PinHeader_1x08_P2.54mm_Vertical
J603: I2C OLED; PinHeader_1x04_P2.54mm_Vertical
J604: LED; PinHeader_1x02_P2.54mm_Vertical
SW601: Play/Pause; SW_PUSH_6mm
SW603: Prev; SW_PUSH_6mm
SW604: Next; SW_PUSH_6mm
SW605: Vol -; SW_PUSH_6mm
SW606: Vol +; SW_PUSH_6mm

Connections:
+3V3: J601.1, J602.1, J602.7, J602.8, J603.2
/BTN1: J601.7, SW601.1
/BTN3: J601.8, SW603.1
/BTN4: J601.9, SW604.1
/BTN5: J601.10, SW605.1
/BTN6: J601.11, SW606.1
/DISP_CS: J601.5, J602.5
/DISP_DC: J601.6, J602.6
/DISP_MOSI: J601.4, J602.3, J603.4
/DISP_SCK: J601.3, J602.4, J603.3
/LED: J601.12, J604.1
GND: J601.2, J602.2, J603.1, J604.2, SW601.2, SW603.2, SW604.2, SW605.2, SW606.2

Notes on the sheet:
Front panel Buttons and headers only, so the panel can be swapped for any wiring. Fit J602 for the SPI ST7789 (as on the Audio Kit build) or J603 for an I2C OLED (then fit R105/R106 on the main board). Check the module's pin order before soldering: OLED modules come as GND-VCC-SCL-SDA and VCC-GND-S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

Board: 2 copper layers, 13 parts (1 on the bottom side), 12 nets, no tracks yet.

Other parts of the board:
H1, H2, H3, H4: MountingHole_3.2mm_M3
