Boisti13/esp32-sendspin-speaker/hardware/usb/sendspin-speaker-usb.kicad_pcb

## KiCad design hardware/usb/sendspin-speaker-usb.kicad_pcb (2026-10-30)

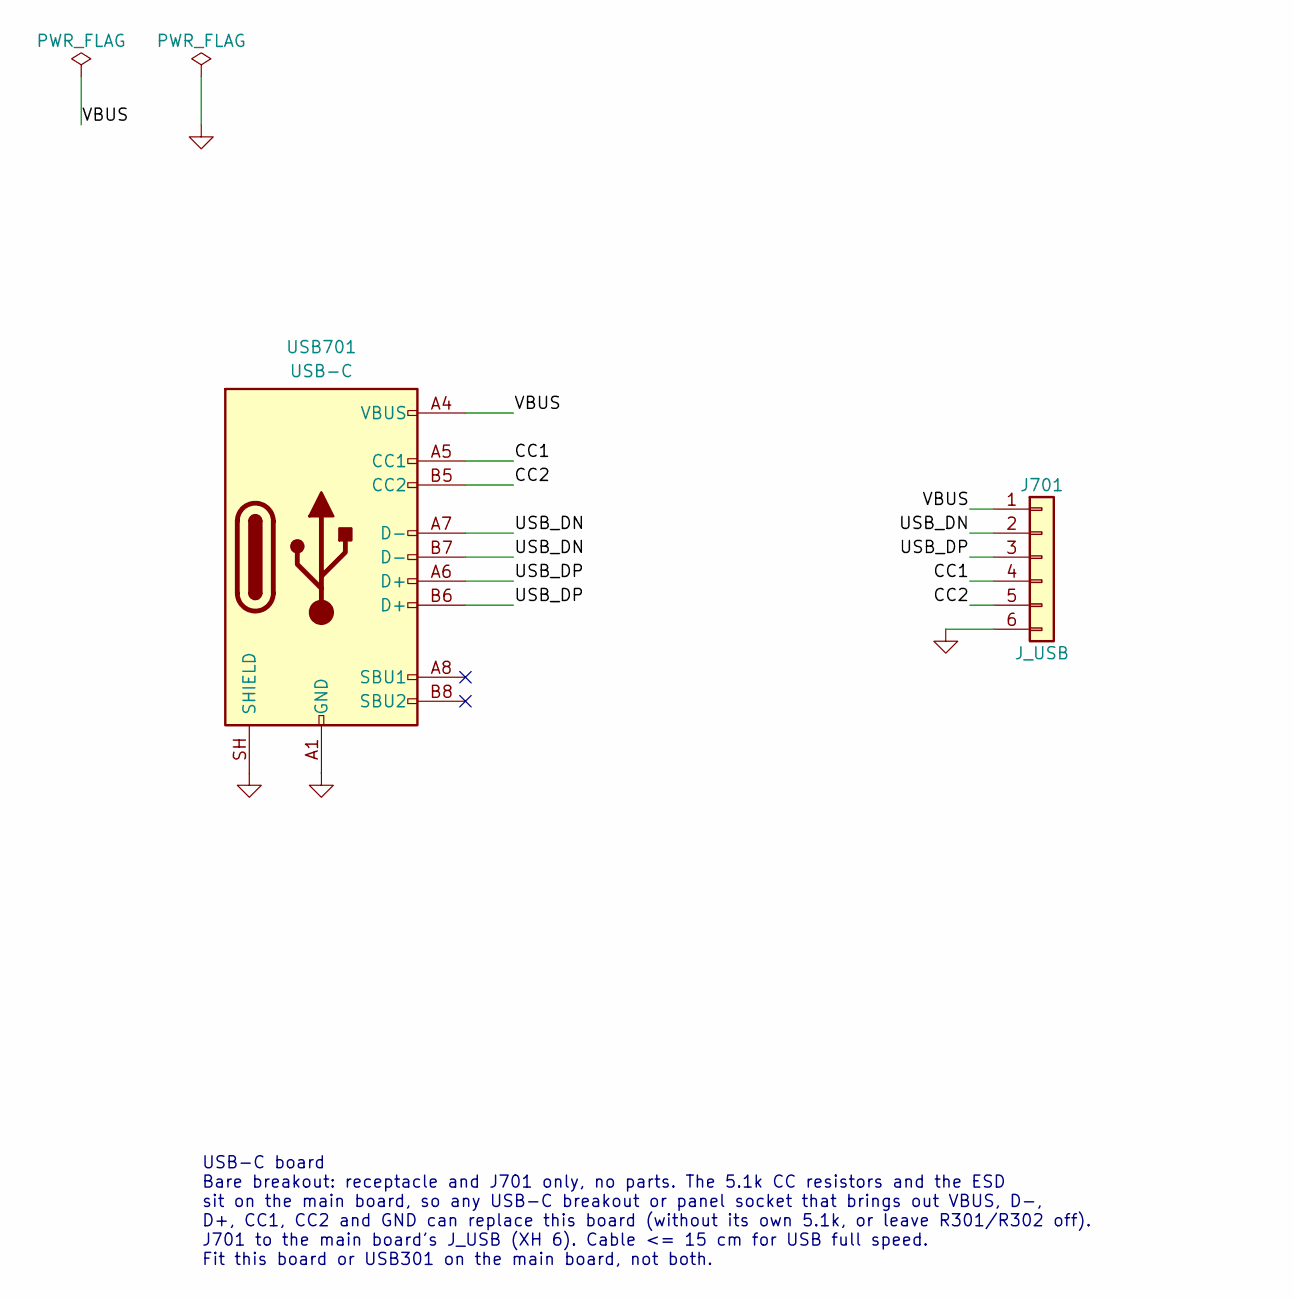
[picture p13: schematic sendspin-speaker-usb.kicad_sch, ESP32 Sendspin Speaker — USB-C board]

Parts:
J701: J_USB; JST_XH_B6B-XH-A_1x06_P2.50mm_Vertical
USB701: USB-C; USB_C_Receptacle_HRO_TYPE-C-31-M-12

Connections:
/CC1: J701.4, USB701.A5 (CC1)
/CC2: J701.5, USB701.B5 (CC2)
/USB_DN: J701.2, USB701.A7 (D-), USB701.B7 (D-)
/USB_DP: J701.3, USB701.A6 (D+), USB701.B6 (D+)
/VBUS: J701.1, USB701.A4 (VBUS), USB701.A9 (VBUS), USB701.B4 (VBUS), USB701.B9 (VBUS)
GND: J701.6, USB701.A1 (GND), USB701.A12 (GND), USB701.B1 (GND), USB701.B12 (GND), USB701.SH (SHIELD)

Notes on the sheet:
USB-C board Bare breakout: receptacle and J701 only, no parts. The 5.1k CC resistors and the ESD sit on the main board, so any USB-C breakout or panel socket that brings out VBUS, D-, D+, CC1, CC2 and GND can replace this board (without its own 5.1k, or leave R301/R302 off). J701 to the main board'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

Board: 2 copper layers, 4 parts (0 on the bottom side), 6 nets, no tracks yet.

Other parts of the board:
H1, H2: MountingHole_2.2mm_M2
