Boisti13/esp32-sendspin-speaker/(commit log)

2026-10-27 v0.2.0: built-in Sendspin (ESPHome 2026.10), keys without HA, boot/amp/screen fixes
    [speaker.yaml]
2026-10-27 v0.3.0: buttons named after what they do
2026-10-27 v0.4.0: new button layout (1 play/pause, 3/4 prev/next, 5/6 volume)
2026-10-29 v0.6.0: boot chime at power-on, Boot Sound switch
2026-10-29 v0.6.1: play/pause no longer replays the boot chime
    [speaker.yaml]
2026-10-30 Add hardware/: KiCad 10 project for a custom PCB
    Empty Rev A project (schematic, board, project-local symbol and
    footprint libraries), parts list and pin plan in hardware/README.md,
    CERN-OHL-P-2.0 for the hardware. KiCad ignores, docs and CLAUDE.md
    rules for hardware work.
    [sendspin-speaker.kicad_pcb, sendspin-speaker.kicad_sch]
2026-10-30 hardware: split into main, front panel and USB-C boards
    Three KiCad projects (main/, ui/, usb/) sharing hardware/lib/. JST
    connector plan for the front panel, USB-C board (or USB-C on the main
    board), LiPo, speakers and status LED; 0805 for SMD passives and LEDs
    wherever possible.
    [sendspin-speaker-main.kicad_pcb, sendspin-speaker-main.kicad_sch, sendspin-speaker-ui.kicad_pcb, sendspin-speaker-ui.kicad_sch, sendspin-speaker-usb.kicad_pcb, sendspin-speaker-usb.kicad_sch]
2026-10-30 hardware: convert KiCad files to the KiCad 10 format
    [sendspin-speaker-main.kicad_pcb, sendspin-speaker-main.kicad_sch, sendspin-speaker-ui.kicad_pcb, sendspin-speaker-ui.kicad_sch, sendspin-speaker-usb.kicad_pcb, sendspin-speaker-usb.kicad_sch]
2026-10-30 hardware: main board block diagram (five hierarchical sheets)
    [audio.kicad_sch, connectors.kicad_sch, mcu.kicad_sch, power.kicad_sch, sendspin-speaker-main.kicad_sch, usb.kicad_sch]
2026-10-30 hardware: footprints for every part, LCSC library, real A1S pin plan
    - lib/lcsc: ESP32-A1S, NS4150B, FS8205A, MSK12C02, PJ-320D imported
    from LCSC with easyeda2kicad (3D paths fixed, NPTH pegs, A1S antenna
    keepout and courtyard), registered in all three projects.
    - Parts table with footprint and LCSC number in hardware/README.md.
    - The A1S keeps the codec's I2C/I2S inside: display moves to the
    ST7789's pins 14/13/15/22 (SPI or I2C), LED to 12, CHRG/STDBY to 4/2
    through BAT54W. J_SW and J_CHG for an off-board switch and charge LEDs.
    - Block sheets use the module's real outputs (HPOUTL/R, SPOLP/N, SPORP/N).
    [audio.kicad_sch, connectors.kicad_sch, mcu.kicad_sch, power.kicad_sch, sendspin-speaker-main.kicad_sch, usb.kicad_sch]
2026-10-30 hardware: MCU sheet (ESP32-A1S, EN/Boot/Reset, pull-ups, status LED)
    [mcu.kicad_sch]
2026-10-30 hardware: Power sheet (charger, protection, load sharing, switch, 3V3, battery sense)
    [power.kicad_sch]
2026-10-30 hardware: tidy the Power sheet layout (netlist unchanged)
    [power.kicad_sch]
2026-10-30 hardware: USB, Audio and Connectors sheets; main board ERC clean
    [audio.kicad_sch, connectors.kicad_sch, usb.kicad_sch]
2026-10-30 hardware: ignore KiCad's local history folder
2026-10-30 hardware: front panel and USB-C board schematics; docs
    All three projects pass ERC with 0 violations and every part has its
    footprint. Open checks (PJ-320D pinout, NS4150B values) in the README.
    [connectors.kicad_sch, sendspin-speaker-ui.kicad_sch, sendspin-speaker-usb.kicad_sch]
2026-10-30 hardware: footprints and nets in all three boards, JLC design rules
    - Update PCB from Schematic on main, front panel and USB-C board.
    - Design rules for JLCPCB 2-layer (0.15 mm track/clearance, 0.3 mm
    drill, 0.6 mm vias, 0.3 mm to the edge); net classes Power (1.0 mm),
    Speaker (0.6 mm), Supply3V3 (0.4 mm).
    - TP4056 on the SOIC-8-EP footprint without 0.2 mm thermal vias;
    MSK12C02 footprint marked SMD, its shell pads to GND.
    - Generator keeps symbol UUIDs stable so regenerated sheets stay linked.
    [power.kicad_sch, sendspin-speaker-main.kicad_pcb, sendspin-speaker-ui.kicad_pcb, sendspin-speaker-usb.kicad_pcb]
2026-10-30 hardware: first placement of all three boards
    Outlines, mounting holes, edge connectors, parts by function and GND
    pours, written with KiCad's Python (scripts/pcbplace.py, place_*.py).
    DRC: no copper or courtyard errors; unrouted connections and silkscreen
    text remain. Renders in hardware/docs/.
    [sendspin-speaker-main.kicad_pcb, sendspin-speaker-ui.kicad_pcb, sendspin-speaker-usb.kicad_pcb]
2026-10-30 hardware: bare USB-C board and front panel (schematics)
    J_USB carries CC1/CC2 (XH 6); CC resistors and ESD stay on the main
    board. Front panel has only buttons and headers; its LED pin comes
    through R501. Boards not yet updated from the schematics.
    [connectors.kicad_sch, sendspin-speaker-ui.kicad_sch, sendspin-speaker-usb.kicad_sch, usb.kicad_sch]
2026-10-30 hardware: bare panel/USB-C boards updated, XH battery, holes in, round corners
    - Boards updated from the schematics: J_USB XH 6 with CC1/CC2, panel
    without parts (J604 LED header), USB-C board without parts.
    - J_BAT JST XH 2.
    - M3 holes 4.5 mm in from the edges (heads stay on the board), M2 3 mm;
    rounded corners. DRC: no copper, courtyard or outline errors.
    [power.kicad_sch, sendspin-speaker-main.kicad_pcb, sendspin-speaker-ui.kicad_pcb, sendspin-speaker-usb.kicad_pcb]
2026-10-30 hardware: main board passives at their pins, amps by the speaker outputs
    place_main.py puts each passive next to the pin it serves (nearest free
    spot, pcbplace.near); amps and speaker connectors move to the right of
    the module. Connection length 2472 -> 1906 mm. PJ-320D footprint: added
    courtyard, 3D model offset onto its pads. DRC: no copper/courtyard errors.
    [sendspin-speaker-main.kicad_pcb]
2026-10-30 hardware: main board routed and labelled, JLC files
    - Freerouting (jar, portable Java 25) via scripts/route.py; net classes
    Power 0.8 mm / Supply 0.4 mm so tracks fit the fine-pitch pins.
    - Silkscreen pin names and function labels (silk_main.py), references on
    the fab layer, SMD GND pads solid to the pour; board 100 x 58 mm.
    - LCSC numbers on all SMD parts (checked on lcsc.com); jlc.py writes the
    Gerber ZIP, BOM and CPL in JLC's formats.
    [audio.kicad_sch, connectors.kicad_sch, mcu.kicad_sch, power.kicad_sch, sendspin-speaker-main.kicad_pcb, usb.kicad_sch]
2026-10-30 hardware: headphone jack removed, main board 70 x 60 mm
    - J403, C422, C423 out; HPOUTL/R open, GPIO39 spare with its pull-up.
    - Main board re-placed on 70 x 60 mm (decoupling placed first), routed,
    labelled; route.py cleans dangling vias and sub-minimum tracks.
    - LCSC fields rewritten after regenerating MCU and Audio sheets.
    [audio.kicad_sch, mcu.kicad_sch, sendspin-speaker-main.kicad_pcb, sendspin-speaker-main.kicad_sch]
2026-11-01 v0.7.1: fix task-watchdog restarts while playing
    The speaker restarted every ~30 min while playing. The crash record
    (esp32.crash) shows a task WDT on core 1 inside Sendspin's protocol task,
    decrypting inbound audio (noise-c / libsodium poly1305). Refilling the
    2.5 MB buffer kept that task busy long enough to starve the main loop.
    Sendspin's task stacks move from PSRAM to internal RAM and the CPU runs
    at 240 MHz.
    [speaker.yaml]
2026-11-01 v0.7.2: Sendspin buffer back to 1 MB
    On v0.7.1 a 2.5 MB refill after a reconnect still blocked the main loop
    for 4.1-4.3 s (playback_started / sendspin "took a long time"), close to
    the task watchdog. The default 1 MB makes refills 2.5x shorter.
    [speaker.yaml]
2026-11-01 v0.7.3: buffer back to 2.5 MB
    v0.7.2's 1 MB made dropouts worse: the speaker has receive stalls of
    4-50 s independent of refills, and 1 MB ran dry on every one over ~5 s.
    Keeps v0.7.1's internal-RAM stacks and 240 MHz.
    [speaker.yaml]
2026-11-02 v0.7.4: Reset Reason diagnostic sensor
    Since v0.7.3 one restart left no crash record and two freezes needed a
    power cycle; the reset reason tells brownout from watchdog and power-on.
    [speaker.yaml]
