Boisti13/esp32-sendspin-speaker/(notices)

Notices in the files:
hardware/main/sendspin-speaker-main.kicad_pcb:
CERN-OHL-P-2.0 github.com/Boisti13/esp32-sendspin-speaker
